marcovannoord/Prusa-i3v2/Manual/IMG_9357.JPG

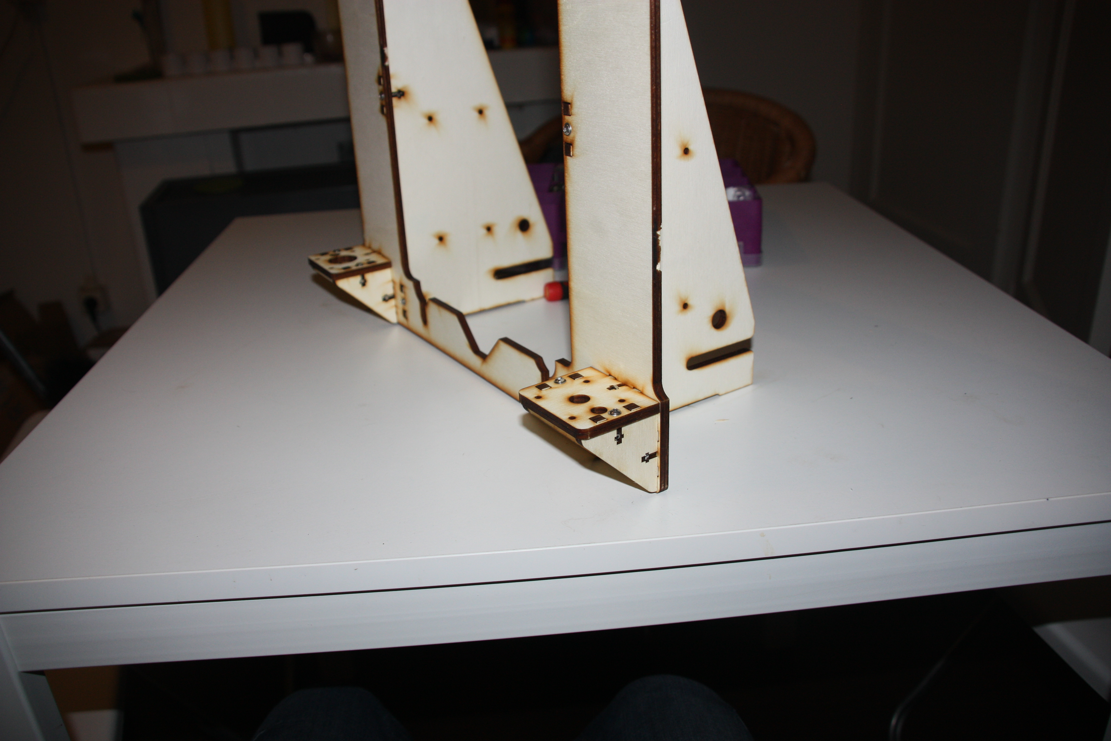
Manual/IMG_9357.JPG
