marcovannoord/Prusa-i3v2/Manual/IMG_9355.JPG

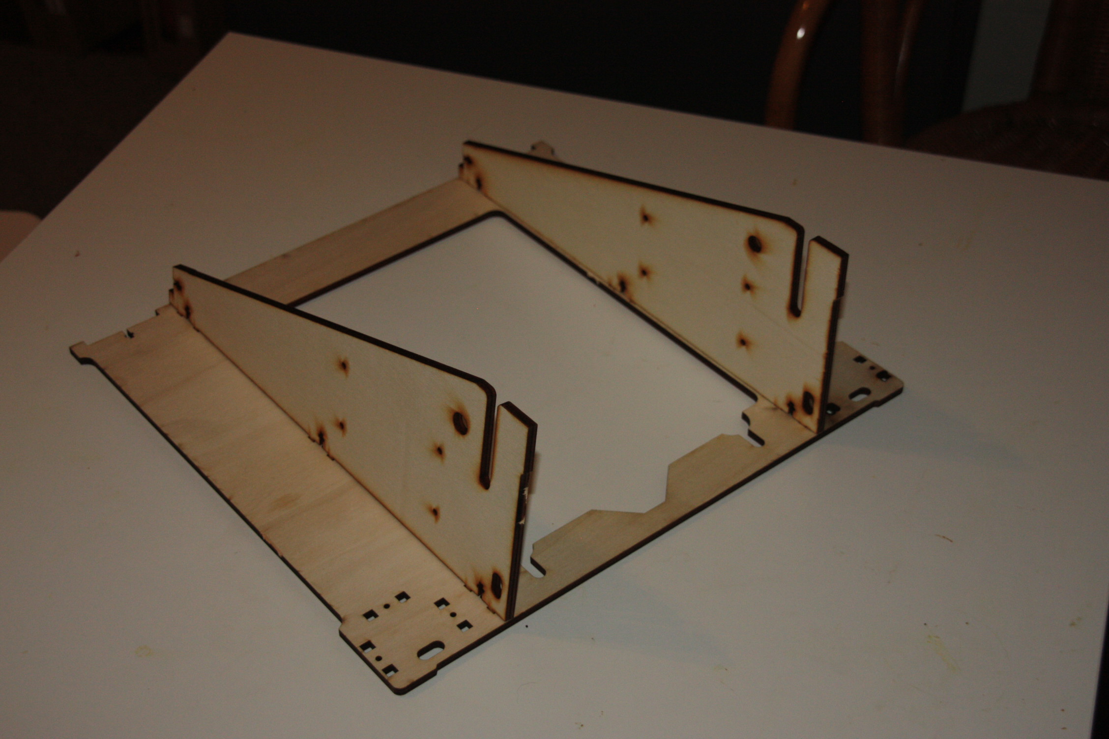
Manual/IMG_9355.JPG
