marcovannoord/Prusa-i3v2/README.md

Prusa-i3v2
==========

upgraded version of the Prusa i3
