marcovannoord/Prusa-i3v2/Laser_cut_files/prusa_i3_one_small_z-Tripoint_bed_lasercut.dxf

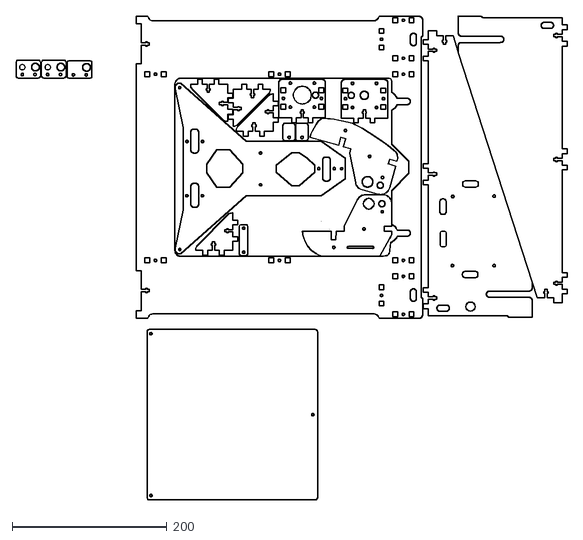
[picture p30: CAD file, 2014-05-31]
Laser_cut_files/prusa_i3_one_small_z-Tripoint_bed_lasercut.dxf
711.0 x 624.3
