marcovannoord/Prusa-i3v2/X-carriage_for_direct_drive.stl

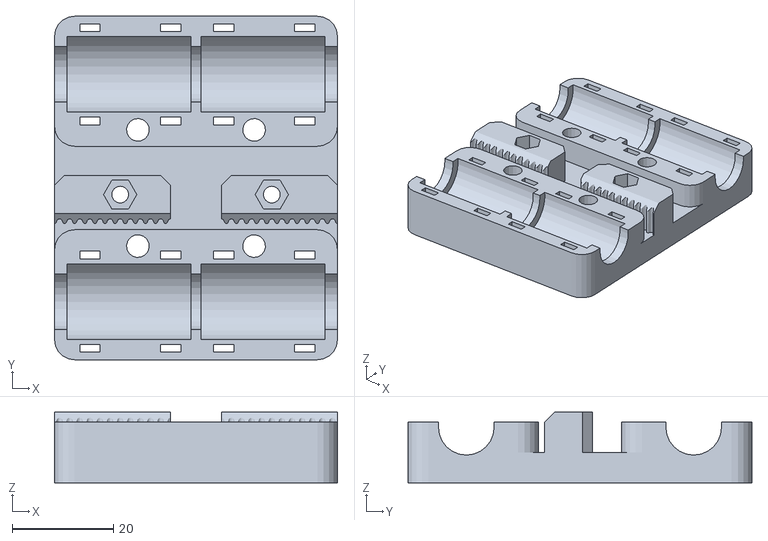
[picture p31: CAD file, 2016-03-13]
X-carriage_for_direct_drive.stl
56.0 x 68.0 x 14.0
