marcovannoord/Prusa-i3v2/FAN-DUCT.stl

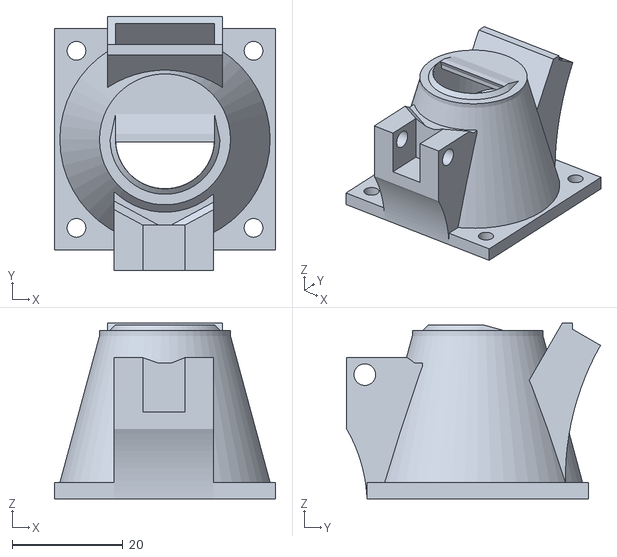
[picture p32: CAD file, 2016-03-13]
FAN-DUCT.stl
40.0 x 45.9 x 31.7
