marcovannoord/Prusa-i3v2/extruder_direct_drive.stl

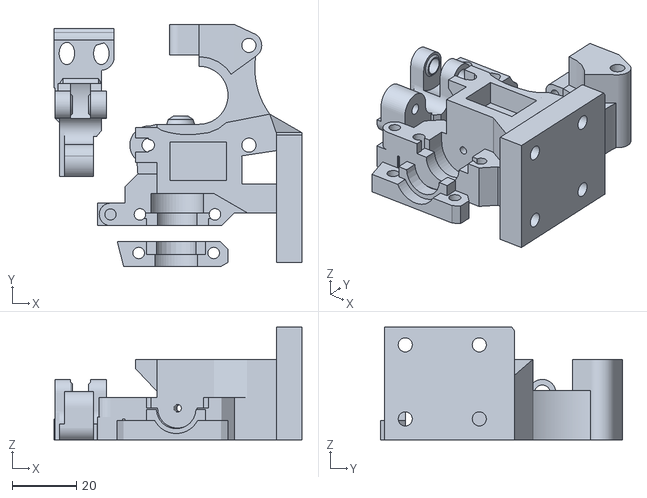
[picture p33: CAD file, 2015-12-14]
extruder_direct_drive.stl
77.1 x 75.2 x 35.0
