marcovannoord/Prusa-i3v2/gregs-wade-extruder-v5.5.stl

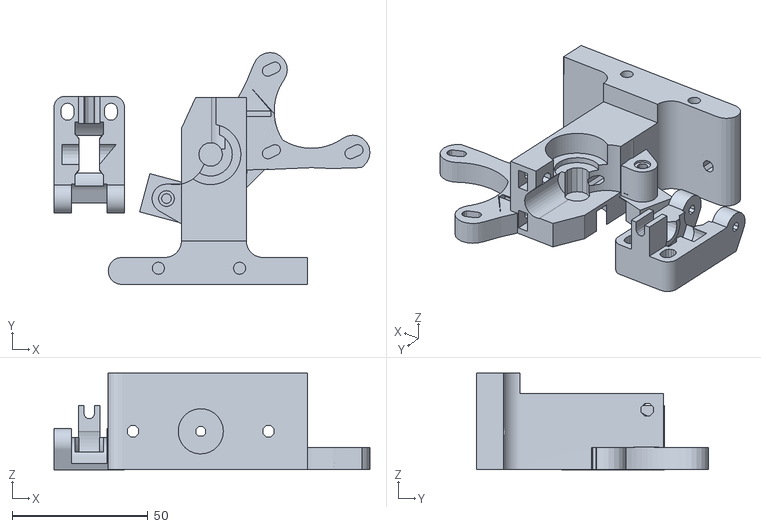
[picture p34: CAD file, 2014-11-14]
gregs-wade-extruder-v5.5.stl
116.6 x 85.6 x 35.8
