marcovannoord/Prusa-i3v2/endstop-holder-z.stl

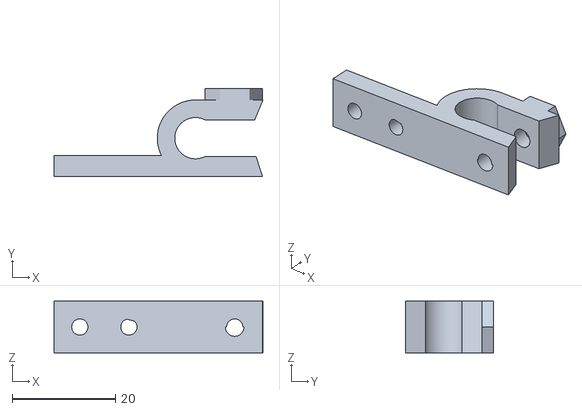
[picture p35: CAD file, 2014-11-14]
endstop-holder-z.stl
40.5 x 17.0 x 10.0
