marcovannoord/Prusa-i3v2/x_motor_newDesign.stl

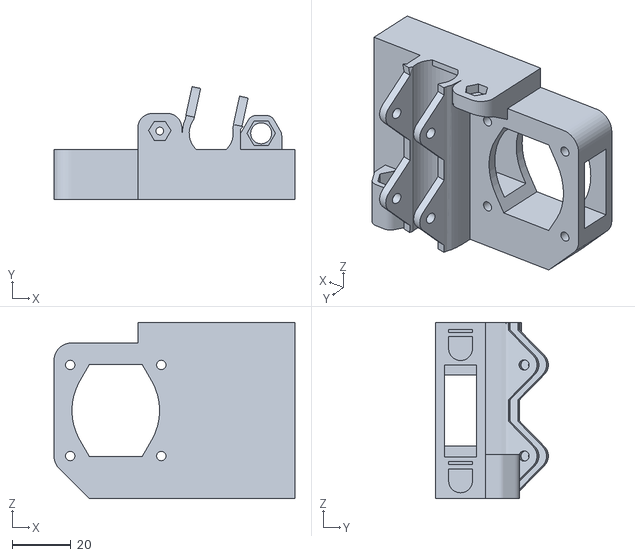
[picture p36: CAD file, 2014-11-14]
x_motor_newDesign.stl
82.0 x 38.4 x 60.0
