marcovannoord/Prusa-i3v2/x-carriage.stl

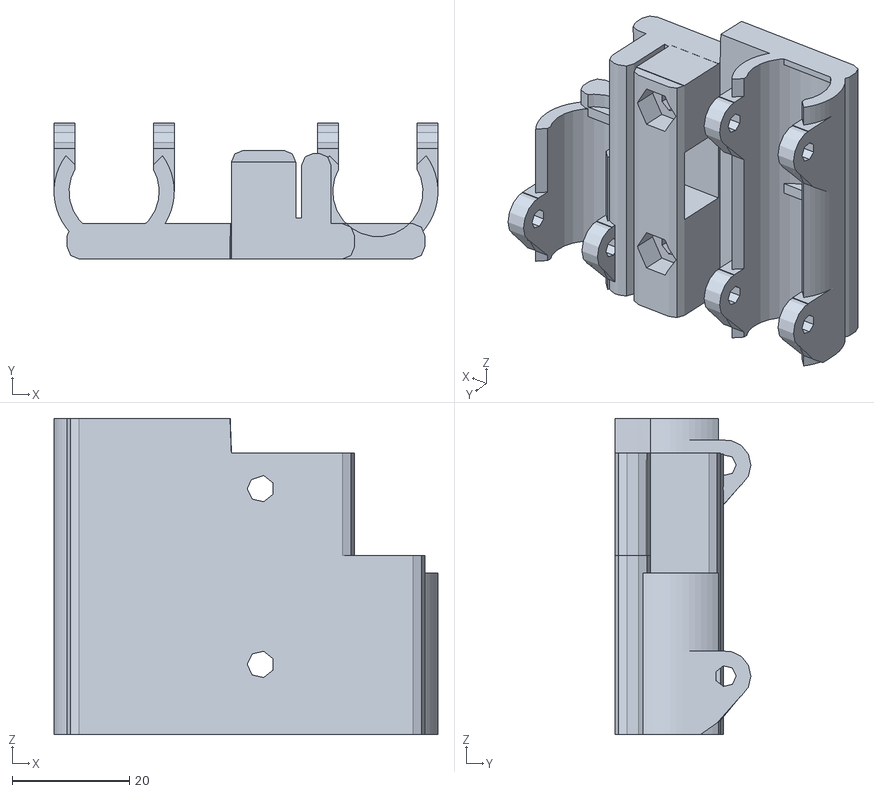
[picture p37: CAD file, 2014-06-01]
x-carriage.stl
65.5 x 23.2 x 54.0
