marcovannoord/Prusa-i3v2/x-belt-spannerplate.stl

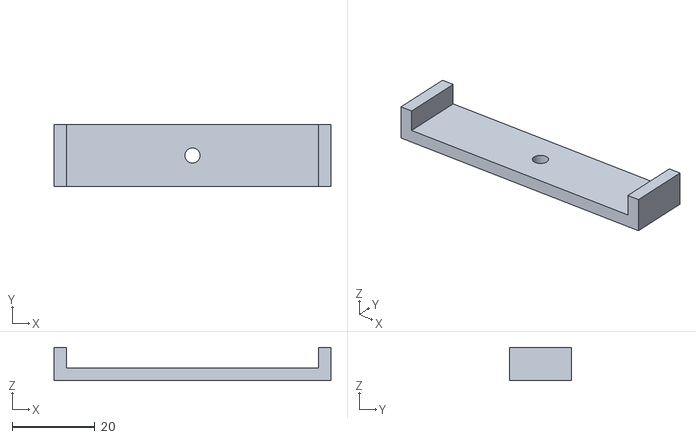
[picture p38: CAD file, 2014-05-04]
x-belt-spannerplate.stl
67.0 x 15.0 x 8.00
