marcovannoord/Prusa-i3v2/electronics_fanholder.stl

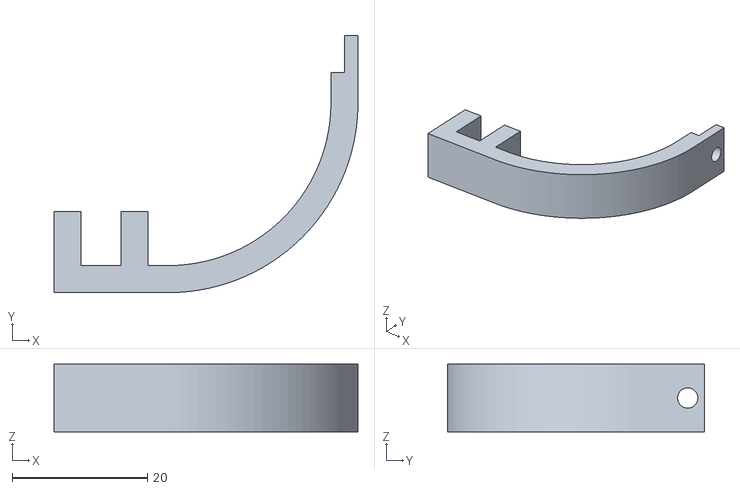
[picture p39: CAD file, 2014-05-04]
electronics_fanholder.stl
44.9 x 38.0 x 10.0
