marcovannoord/Prusa-i3v2/x-belt-spanner.stl

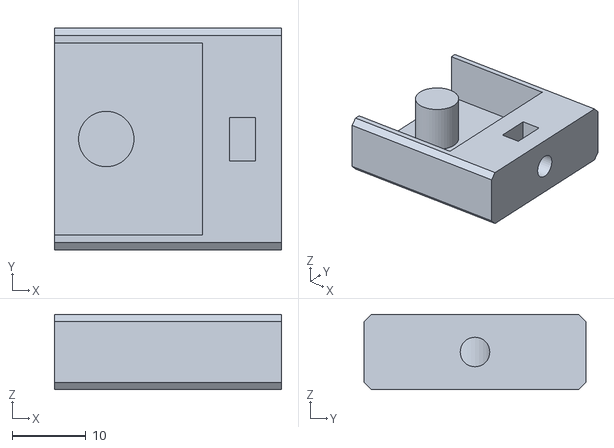
[picture p40: CAD file, 2014-05-04]
x-belt-spanner.stl
30.7 x 30.0 x 10.2
