marcovannoord/Prusa-i3v2/x_end_newDesign.stl

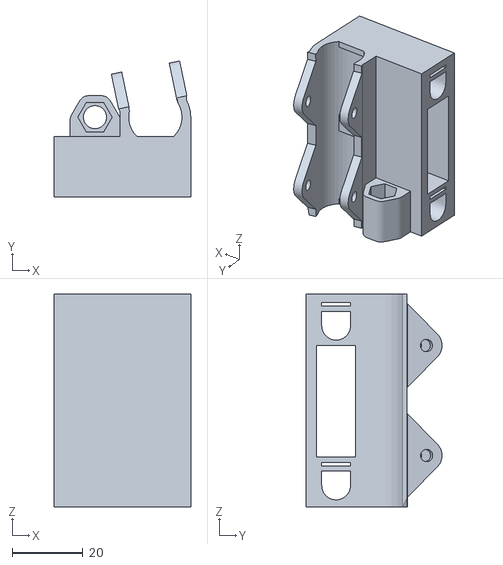
[picture p41: CAD file, 2014-05-04]
x_end_newDesign.stl
38.5 x 38.3 x 60.0
