marcovannoord/Prusa-i3v2/fanmount_40mm_fan.stl

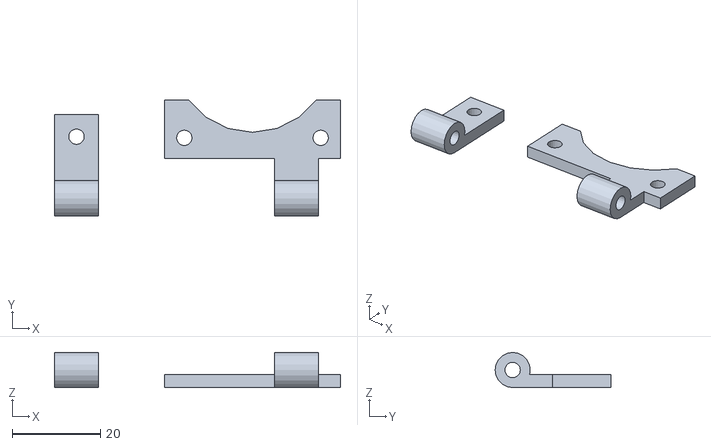
[picture p42: CAD file, 2014-03-22]
fanmount_40mm_fan.stl
65.0 x 26.3 x 8.00
