marcovannoord/Prusa-i3v2/big_and_small_herringbone_gears.stl

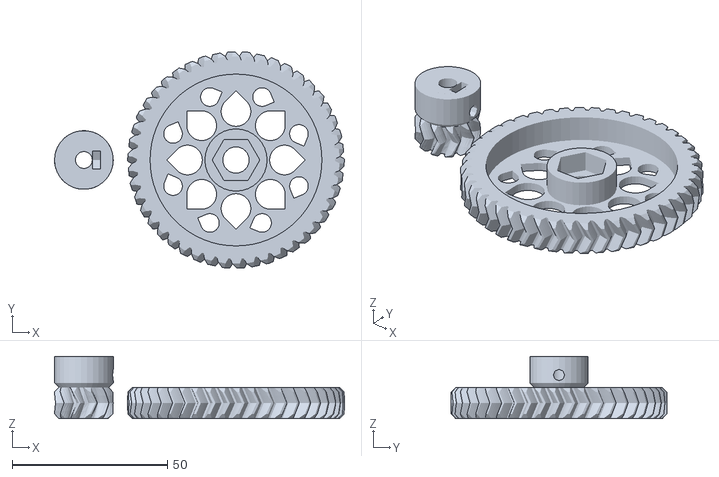
[picture p43: CAD file, 2014-01-30]
big_and_small_herringbone_gears.stl
93.3 x 69.4 x 20.0
