marcovannoord/Prusa-i3v2/fanplate.stl

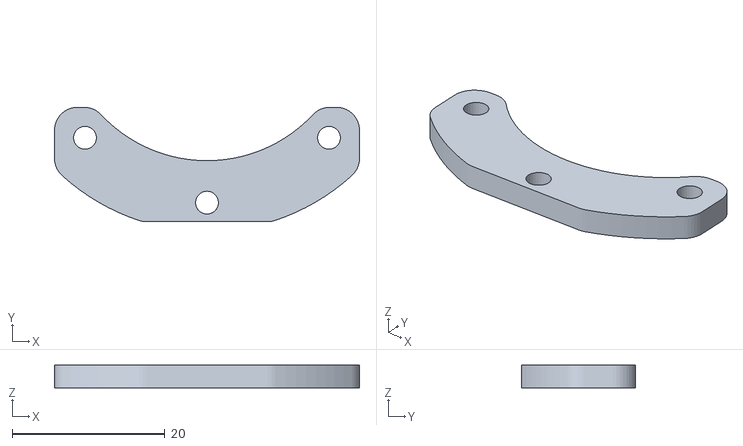
[picture p44: CAD file, 2014-01-07]
fanplate.stl
40.0 x 15.0 x 3.00
