marcovannoord/Prusa-i3v2/y-belt-holder.stl

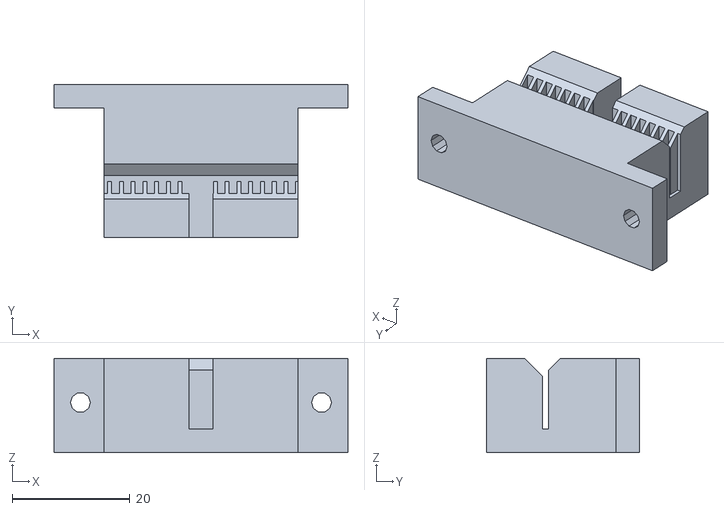
[picture p45: CAD file, 2013-12-10]
y-belt-holder.stl
50.0 x 26.0 x 16.0
