marcovannoord/Prusa-i3v2/y-corners_v2_4pcs.stl

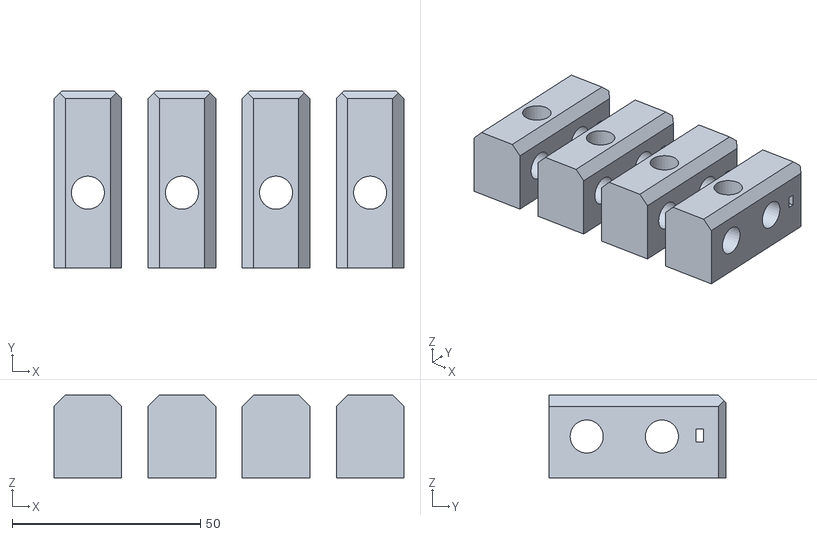
[picture p46: CAD file, 2013-12-09]
y-corners_v2_4pcs.stl
93.0 x 47.0 x 22.0
