marcovannoord/Prusa-i3v2/y-drivetrain.stl

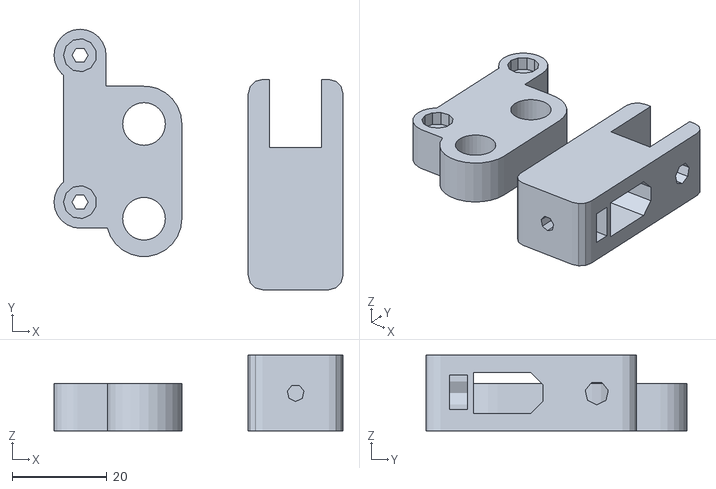
[picture p47: CAD file, 2013-12-09]
y-drivetrain.stl
61.0 x 55.0 x 16.0
