marcovannoord/Prusa-i3v2/(list of files, cad)

Other CAD files:
Deprecated/608_bearing_center.stl
Deprecated/X_End_Idler.stl
Deprecated/X_End_Motor.stl
Deprecated/bearing-flange_608zz.stl
Deprecated/bearing-flange_624zz.stl
Deprecated/big_herringbone.stl
Deprecated/gregs-wade-extruder-v5.2.stl
Deprecated/gregs-wade-extruder-v5.3.stl
Deprecated/gregs-wade-extruder-v5.4.stl
Deprecated/herringbone_small.stl
Deprecated/x-carriage_1.3mm_belt_test.stl
Deprecated/y-drivetrain_608_bearing.stl
gregs-wade-extruder-v5.2.stl
gregs-wade-extruder-v5.3.stl
gregs-wade-extruder-v5.4.stl
