marcovannoord/Prusa-i3v2/Manual/IMG_9356.JPG

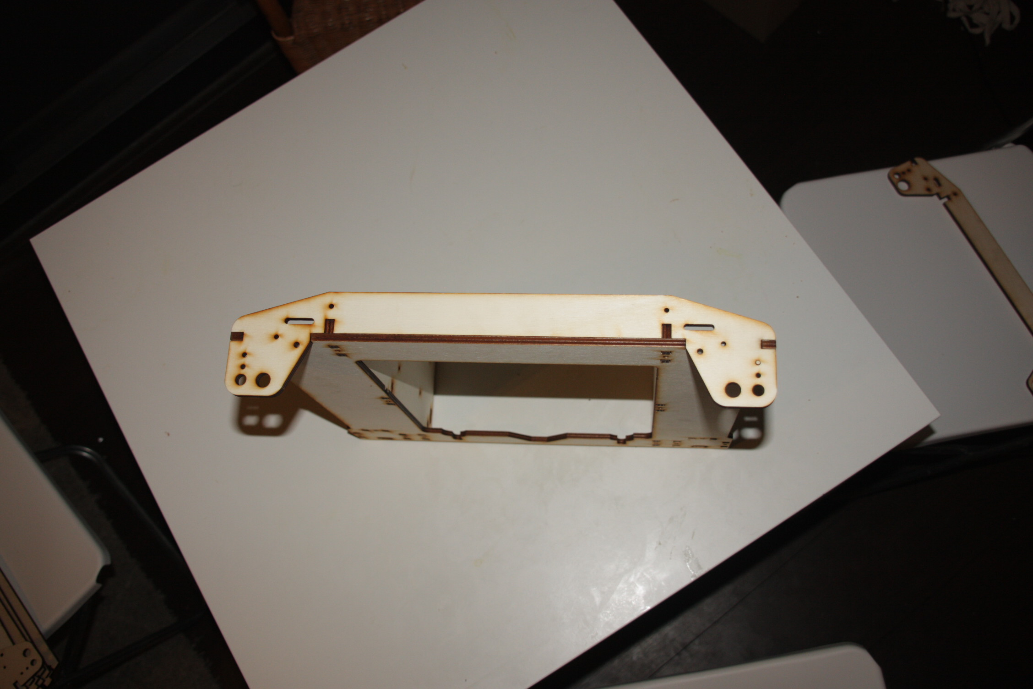
Manual/IMG_9356.JPG
