marcovannoord/Prusa-i3v2/Manual/IMG_9362.JPG

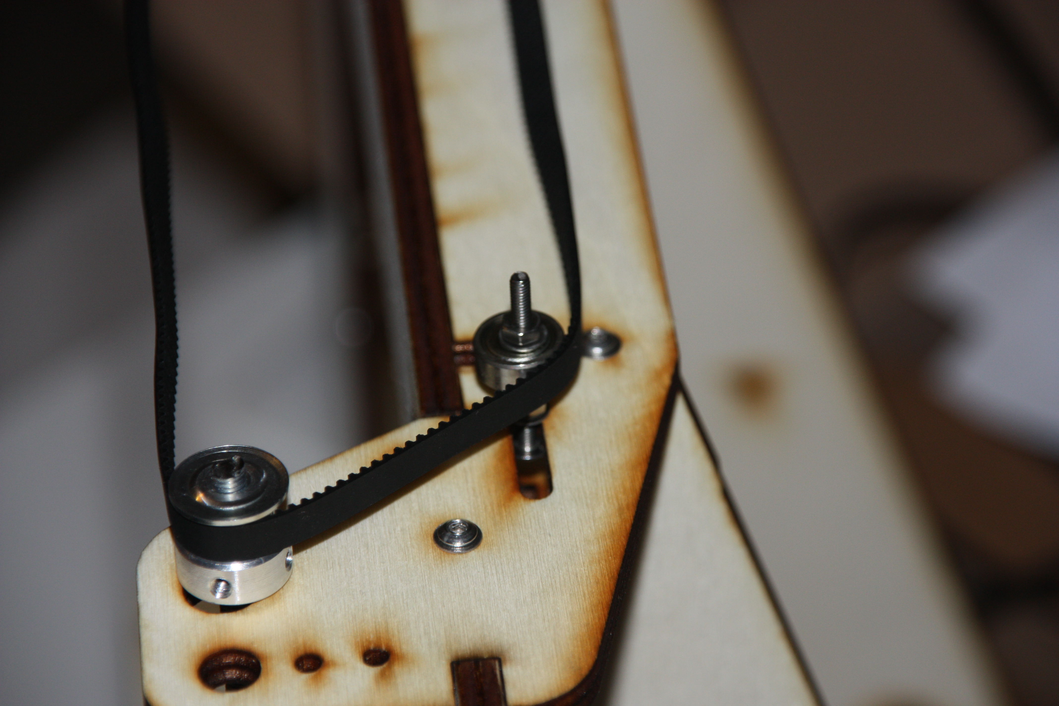
Manual/IMG_9362.JPG
