marcovannoord/Prusa-i3v2/Manual/y.2.png

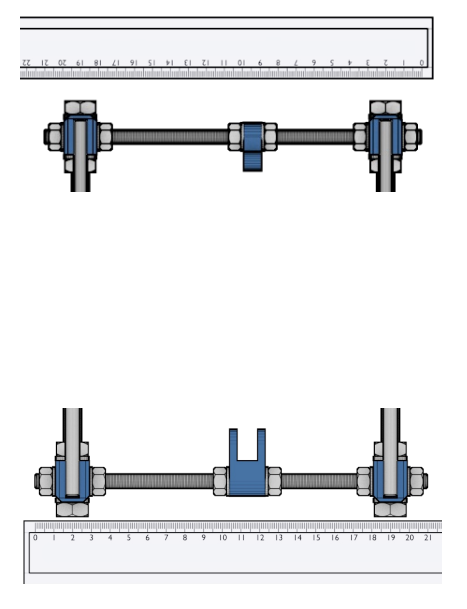
Manual/y.2.png
