marcovannoord/Prusa-i3v2/(commit log)

2013-12-09 added endsto, wade extruder and herringbones
    [End_Stop_Holder.stl, big_herringbone.stl, gregs-wade-v5-2.stl, herringbone_small.stl]
2013-12-09 nieuwe xy-corners, zowel 1 stuk als 4 stuks in een print
    [y-corners_v2.stl, y-corners_v2_4pcs.stl]
2013-12-09 verwijderen oude xy-corners, gat was te klein.
    [Prusa_i3_4_x_Y_Corners.stl]
2013-12-09 new, better versions; removed old duplicated, put laserfiles in separate folder
    [Prusa_i3_X_Carriage.stl, gregs-wade-extruder-v5.2.stl, y-belt-holder.stl, y-motor_holder.stl]
2013-12-09 Added manual v0.2, removed useless files.
    [Prusa_i3_Y_Belt_Clamp_-_0.9mm.stl, X_End_Idler.stl, X_End_Motor.stl]
2013-12-09 improved belt holder
    [y-belt-holder.stl]
2013-12-10 fixed bug where the ribs where too thin
    [y-belt-holder.stl]
2013-12-17 new idlers, committed to 608 bearing
    [608_bearing_center.scad, 608_bearing_center.stl, gregs-wade-extruder-v5.2.stl, y-drivetrain_608_bearing.stl]
2013-12-22 added images of y-axis and added PDF
2013-12-22 new fan mount
    [fanmount_50mm_fan.stl]
2014-01-07 major changes to the z-belt holder, improved sides, added x-belt tensioner, fanholder for minitronics and some minor improvements to the x-carriage
    [X_belt_endplate.stl, X_belt_spanner.stl, fanhold.stl, fanplate.stl, x-carriage.stl, x-carriage_1.3mm_belt_test.stl]
2014-01-14 Some small changes to the z-axis part and did some cleaning up
    [X_belt_endplate.stl]
2014-01-14 added the Marlin firmware, adjusted to the Minitronics v1.0 board
    [Configuration.h, Configuration_adv.h, Menu Plans.xlsx]
2014-01-30 moved some old unused files, fixed some alignment bugs and added improved versions of the x-end and x-motor end.
    [608_bearing_center.scad, 608_bearing_center.stl, Minitronics_fanholder.stl, X_End_Idler_newDesign.stl, X_End_Motor_newDesign.stl, bearing-flange_608zz.stl, bearing-flange_624zz.stl, big_and_small_herringbone_gears.stl]
2014-02-14 nieuwste Marlin toegevoegd, veel bestanden aangepast, handleiding elektronica aansluiten, configuratie verbeterd.
    [Configuration.h, Configuration_adv.h, Menu Plans.xlsx, gregs-wade-extruder-v5.2.stl]
2014-02-24 Updated configuration
    [Configuration.h]
2014-03-22 minor updates
    [endstop-holder.stl, fanmount_40mm_fan.stl]
2014-05-04 Improved endstop holder, fanholder mountbracket, increased size of x-ends to prevent breaking parts while mounting, adjusted size of beltspanner, minor adjustments to wade extruder.
    [End_Stop_Holder.stl, Minitronics_fanholder.stl, X_End_Idler_newDesign.stl, X_End_Motor_newDesign.stl, X_belt_endplate.stl, X_belt_spanner.stl, electronics_fanholder.stl, endstop-holder-z.stl]
2014-05-04 Default EEPROM, make sure x turns the right way
    [Configuration.h]
2014-05-04 completely redid manual, added lots of pictures, added cutting plate for Trotec 300, some minor improvements to .ai files.
    [y-corners_v2.stl]
2014-05-31 The x-axis was going the wrong direction, some improvements to the manual, added more sources for the lasercut files.
    [Configuration.h, prusa_i3_one_small_z-Tripoint_bed_lasercut.dxf]
2014-06-01 added clearance between frame and carriage, increased hole clearance for extruder idler.
    [gregs-wade-extruder-v5.4.stl, x-carriage.stl]
2014-06-06 Added RAMPS configuration
    [Configuration_RAMPS.h]
2014-11-14 Preparing for restructuring
    [Configuration.h, Configuration_RAMPS.h, Configuration_adv.h, Configuration_minitronics.h, Menu Plans.xlsx]
2014-11-14 Moved old Marlin to Deprecated
    [Configuration.h, Configuration_RAMPS.h, Configuration_adv.h, Configuration_minitronics.h, Menu Plans.xlsx]
2014-11-14 Deprecated some old stuff, since we moved to RAMPS 1.4 instead of minitronics
    [X_End_Idler.stl, X_End_Motor.stl, electronics_fanholder.stl, fanmount_50mm_fan.stl]
2014-11-14 endstop-holder fits better now and the z-adjustment screw fits better in the x_motor
    [X_End_Idler.stl, X_End_Motor.stl, endstop-holder-z.stl, wade_extruder_5.4.stl, x_motor_newDesign.stl, y-corners_v2.stl]
2014-11-14 Updated wade extruder, now easier to print, parts fit together slightly better
    [gregs-wade-extruder-v5.2.stl, gregs-wade-extruder-v5.3.stl, gregs-wade-extruder-v5.4.stl, gregs-wade-extruder-v5.5.stl]
2014-11-14 Updated Marlin to latest version, updated config (PID values, speeds), making LCD display default (will work without though), and preparing for auto-bed-leveling.
    [Configuration.h, Configuration_adv.h, Menu Plans.xlsx]
2015-12-14 Cleaning up old, deprecated files
    [Configuration.h, Configuration_adv.h, Configuration_minitronics.h, Menu Plans.xlsx]
2015-12-14 Added Cura profile for 1,75mm filament
2015-12-14 New extruder design, made for 1,75mm filament. Design works a lot better than old design, and is way more reliable
    [extruder_direct_drive.stl]
2016-03-13 Added new x-carriage for direct drive and a fanduct for direct drive
    [FAN-DUCT.stl, X-carriage_for_direct_drive.stl]
