marcovannoord/Prusa-i3v2/Manual/IMG_9358.JPG

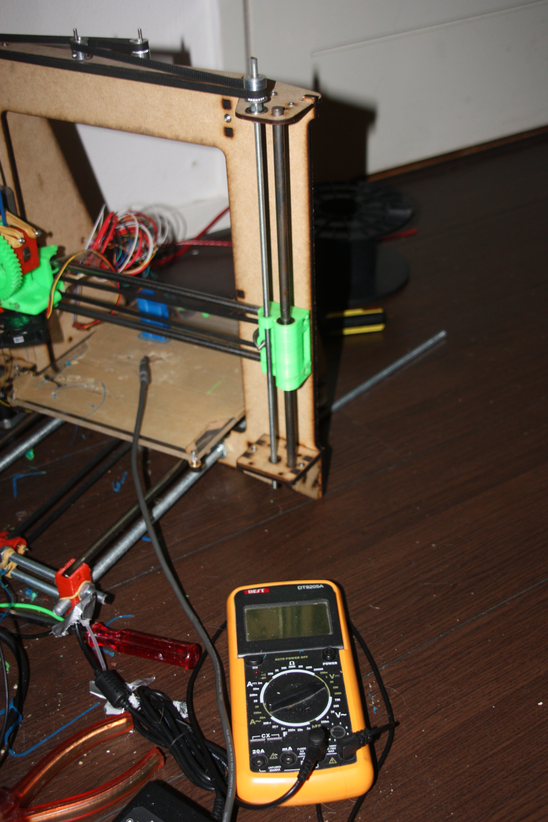
Manual/IMG_9358.JPG
