marcovannoord/Prusa-i3v2/Manual/IMG_9359.JPG

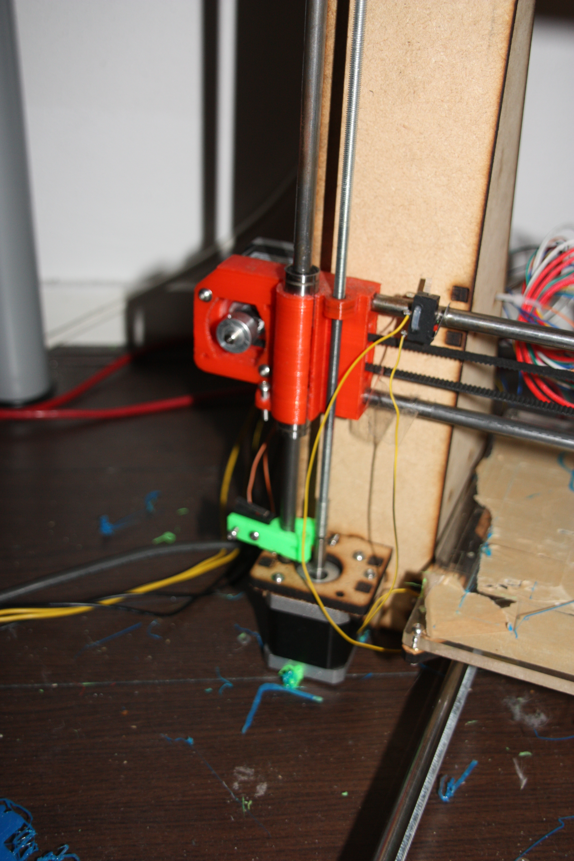
Manual/IMG_9359.JPG
