marcovannoord/Prusa-i3v2/Manual/IMG_9360.JPG

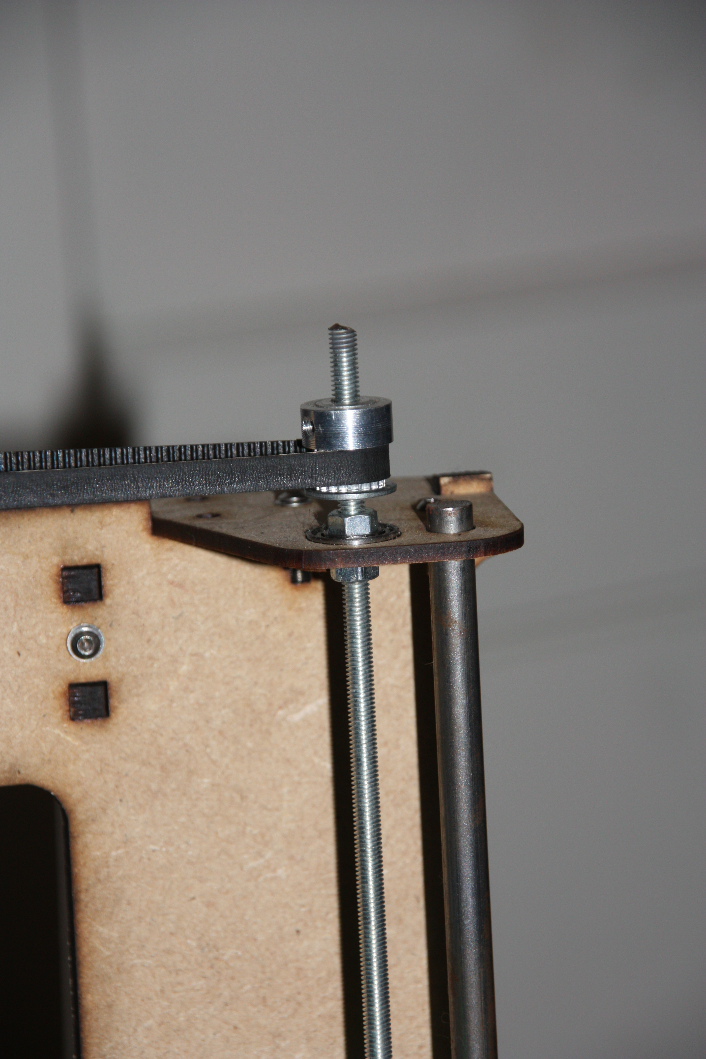
Manual/IMG_9360.JPG
