marcovannoord/Prusa-i3v2/Manual/IMG_9363.JPG

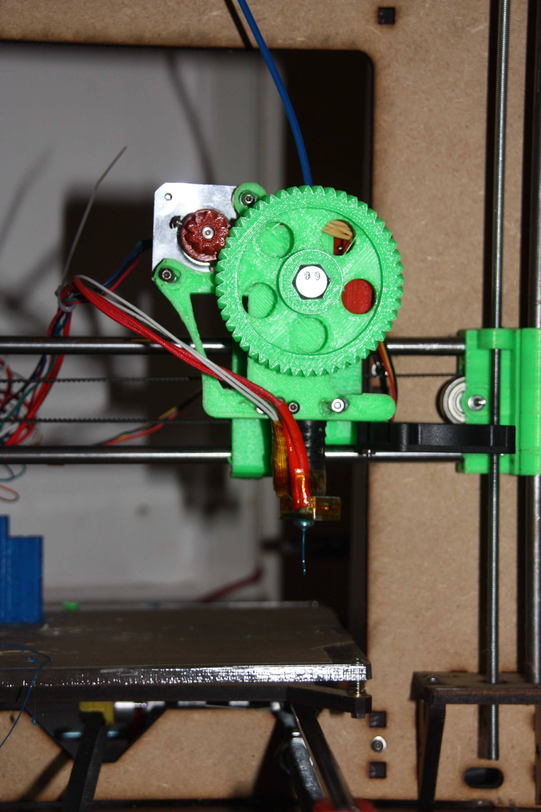
Manual/IMG_9363.JPG
